kcirtapy/diy-talk-box/adapter/thread_test_ring.stl

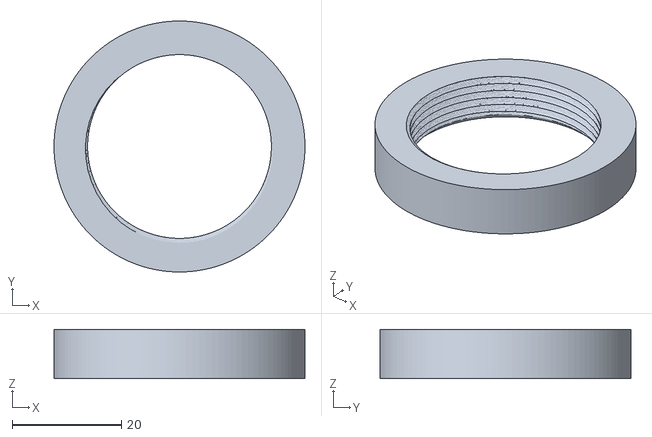
[picture p2: CAD file, 2026-11-03]
adapter/thread_test_ring.stl
46.0 x 46.0 x 9.00
