kcirtapy/diy-talk-box/adapter/talkbox_adapter.stl

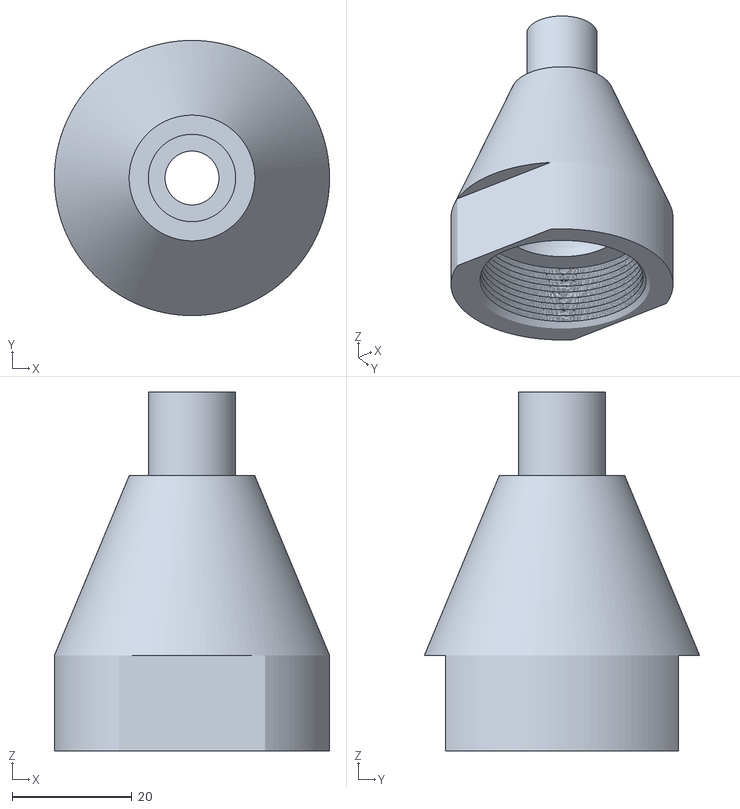
[picture p3: CAD file, 2026-11-03]
adapter/talkbox_adapter.stl
46.0 x 46.0 x 60.0
